pnavarro0102-ai/Sistema-de-Levitacion-Neumatica/(list of files, cad)

Other CAD files:
Diseño3D/AG05.f3d
Diseño3D/AG07.f3d
Diseño3D/AG08.f3z
Diseño3D/AG09.f3z
Diseño3D/AG10.f3d
Diseño3D/Soporte.f3d
Diseño3D/Tubo.f3d
