pnavarro0102-ai/Sistema-de-Levitacion-Neumatica/PLANOS.pdf

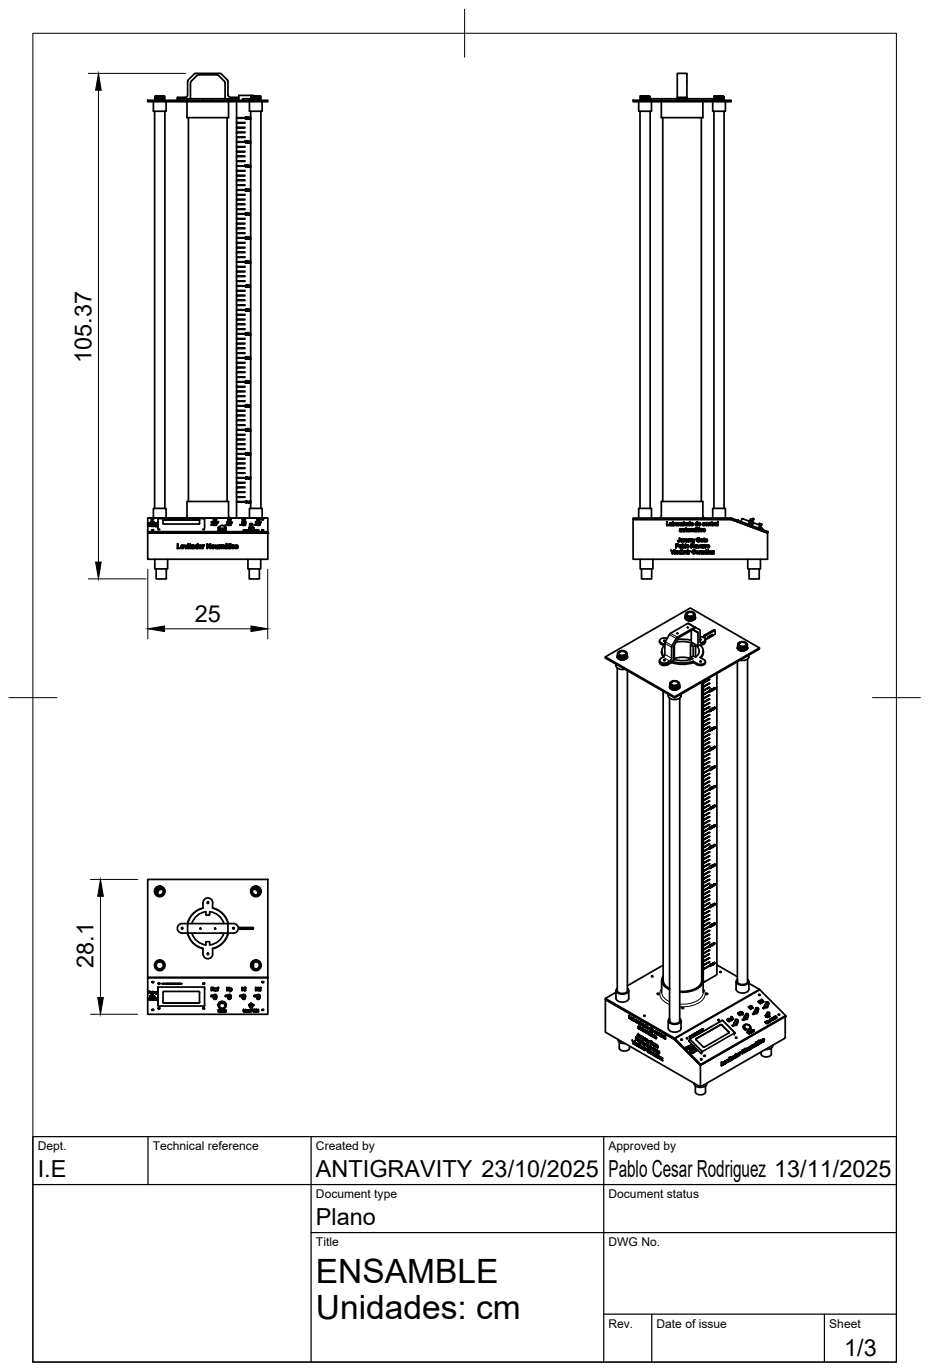
[picture p54: page 1]
Dept.; Technical reference; Created by; Approved by; Document type; Document status; Title; DWG No.; Rev.; Date of issue; Sheet; Unidades: cm; ANTIGRAVITY; Pablo Cesar Rodriguez

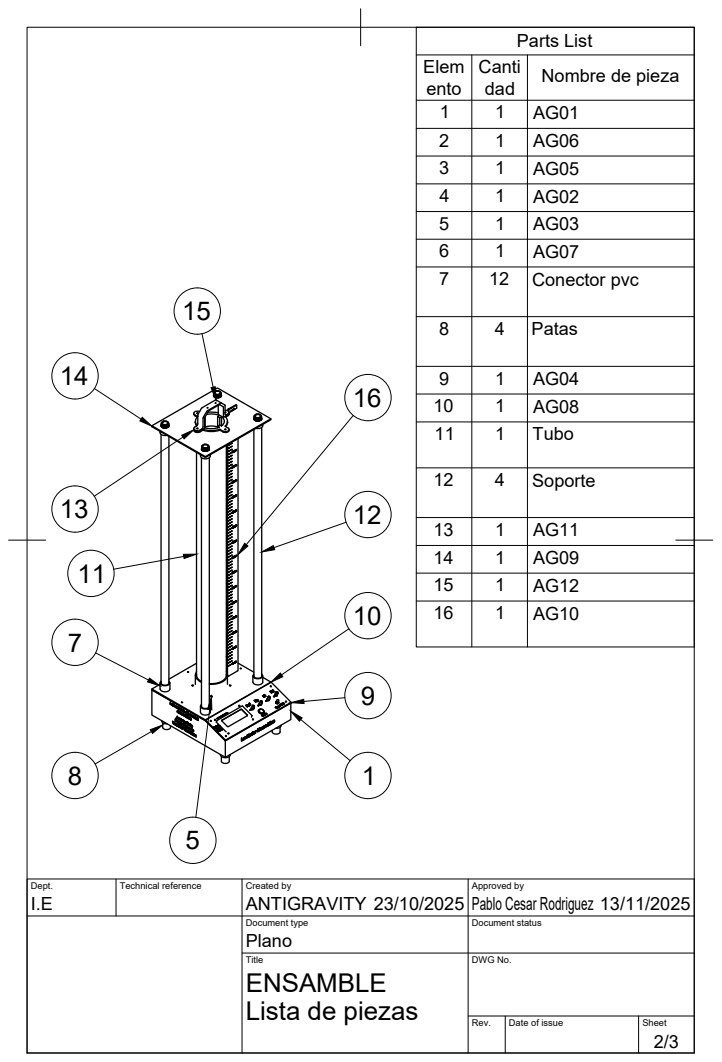
[picture p55: page 2]

Parts List

Elem ento | Canti dad | Nombre de pieza

1 | 1 | AG01
2 | 1 | AG06
3 | 1 | AG05
4 | 1 | AG02
5 | 1 | AG03
6 | 1 | AG07
7 | 12 | Conector pvc

8 | 4 | Patas

9 | 1 | AG04
10 | 1 | AG08
11 | 1 | Tubo

12 | 4 | Soporte

13 | 1 | AG11
14 | 1 | AG09
15 | 1 | AG12
16 | 1 | AG10

Dept. I.E | Technical reference | Created by ANTIGRAVITY 23/10/2025 | Approved by Pablo Cesar Rodriguez 13/11/2025

Document type Plano | Document status

Title ENSAMBLE Lista de piezas | DWG No.

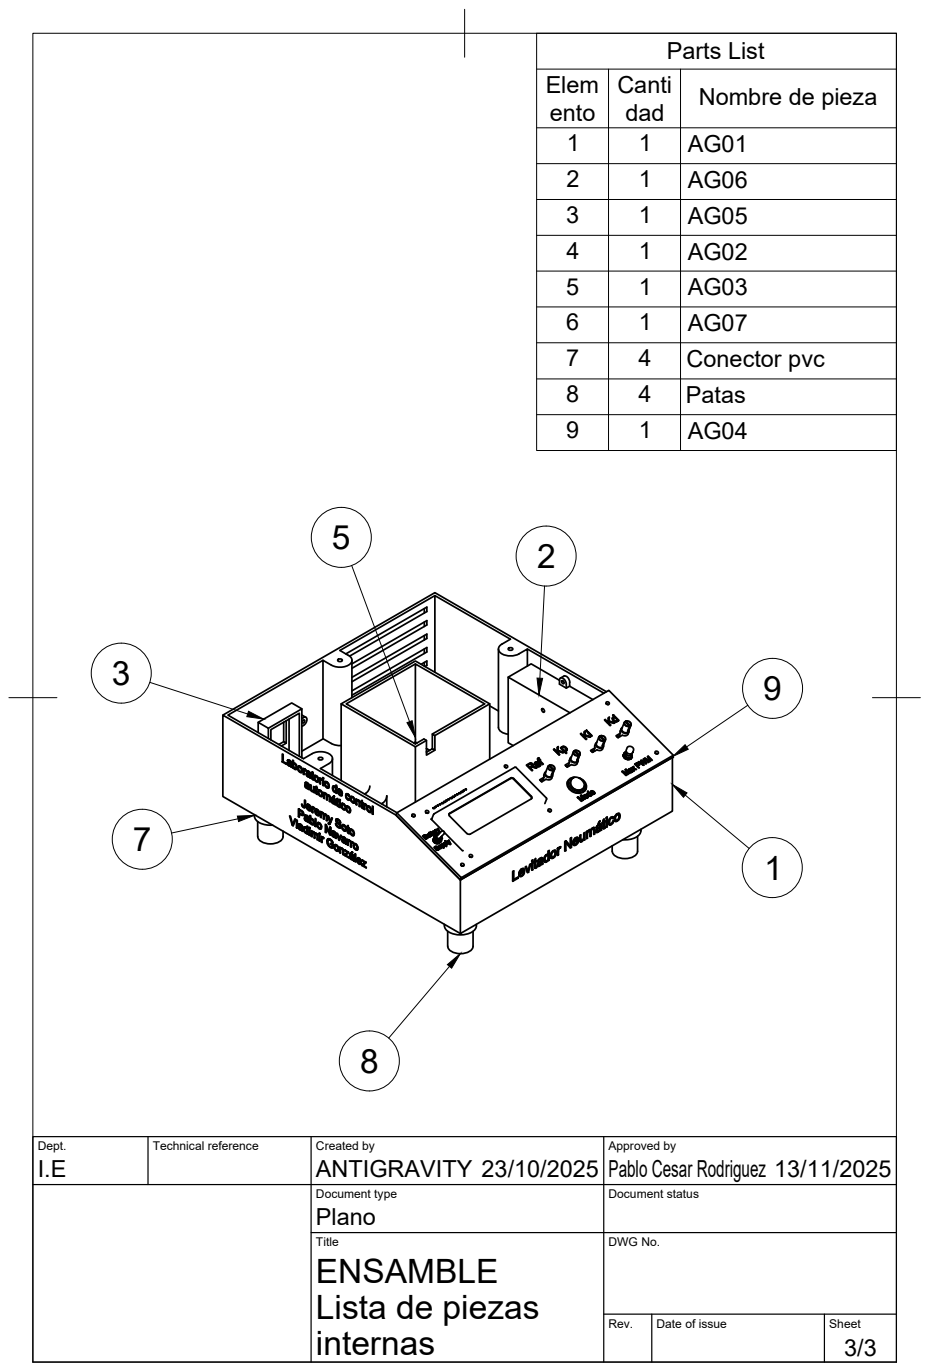
[picture p56: page 3]

Parts List

Elem ento | Canti dad | Nombre de pieza

1 | 1 | AG01
2 | 1 | AG06
3 | 1 | AG05
4 | 1 | AG02
5 | 1 | AG03
6 | 1 | AG07
7 | 4 | Conector pvc
8 | 4 | Patas
9 | 1 | AG04

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

Document type Plano | Document status

Title ENSAMBLE Lista de piezas internas | DWG No.
