pnavarro0102-ai/Sistema-de-Levitacion-Neumatica/(list of files, drawings)

Other design files:
Simulación de circuito/Lcontrol.pdsprj
